TimSchonning/MINTS/README.md

<h1 align="center">Modular Integrated Network of Traffic Sensors (MINTS)</h1>

<!-- PROJECT SHIELDS -->
[][contributors-url]
[][forks-url]
[][stars-url]
[][issues-url]

<!-- ABOUT THE PROJECT -->
## About the Project
**NOTE:** *This project was a part of the authors' bachelor's thesis at Uppsala University.* <br>
[*Click here to access the thesis*][a]

[a]: https://www.diva-portal.org/smash/record.jsf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

MINTS is a star topology network of small, ground-level measurement stations equipped with sensors to monitor air quality and noise pollution in a dense, urban environment. The project aims to combat the flaws associated with traditional monitoring systems, which tend to be expensive, few in number, and often mounted on rooftops, farther from the directly affected areas on the ground.

The stations have been developed to allow for a plug-and-play system that can identify problematic ground-level areas at a greater scale. By continually monitoring affected areas more densely, it's possible to identify pollution patterns and to pinpoint local hotspots. The pollution data gathered by these stations can then be visualized in real-time on an interactive heatmap.

The primary beneficiaries of this project are the municipalities and the people who are troubled by pollution and traffic-related disturbances. Further, it provides the tools for responsive urbanism, making the day-to-day lives of citizens easier.

### Key Features
* **Ground-level Measurements:**    measures ground-level PM and noise pollution.
* **Real-Time Heatmap Generation:** Real-time visualisations of pollution data.
* **Low-Cost System:**              ~100 USD per node.
* **Scalability:**                  Support for upp to hundreds of nodes per gateway.
* **Low-Power LoRa Communication:** Optimised for long-range, battery-efficient data transmissions within an urban, ground-level environment.

<!-- [![Product Name Screen Shot][product-screenshot]](https://example.com) -->
### System Architecture

*For further details, please see chapters 3.3 and 3.4 in the thesis.*

#### Hardware Architecture

The measuring station is designed to be compact, energy-efficient, and easily expandable. It is powered by a 9V supply, providing a 4V overhead to handle battery degradation and protect voltage-sensitive components.

node_circuit

#### Software Architecture
The software architecture consists of four parts working together: frontend,
database, gateway, and node. The goal is to collect data from
the connected sensors, transmit it to the gateway, which uploads it to the
database, which can be read from the frontend to update the heatmap.

sysarc

### Tech Stack and Hardware Components

*For further details, please see chapter 3.2 in the thesis.*

#### Hardware
| Component | Model / Details | Purpose & Key Specifications |
| :--- | :--- | :--- |
| **Particle Sensor** | SEN-HM3301 | Monitors airborne fine particle concentrations ($PM_{1}$ and $PM_{2.5}$). |
| **Sound Sensor** | Waveshare (LM386 Amp) | Captures acoustic data (50–20,000 Hz range, 52 dB sensitivity). |
| **LoRa Module** | Core1262-HF (TCXO) | Handles wireless communication between nodes and the gateway. |
| **Microcontroller** | Arduino Nano (ESP32-S3 SoC) | Serves as the main processing board for each individual node. |
| **Gateway** | Raspberry Pi 3 Model B (1GB) | Bridges communication between the node network and the server. |
| **LoRa HAT** | Waveshare LoRa & GNSS | Gateway add-on board based on the SX1262 radio chip. |
| **Antennas** | 2J0C15-868-C885G & Bundled HAT Antenna | **Nodes:** 868MHz antenna via SMA to U.FL adapters.<br>**Gateway:** High-gain antenna bundled with the HAT. |
| **Misc. Electronics** | Capacitors, Resistors, Regulators | • 2x Electrolytic capacitors (10uF, 16V/50V)<br>• Resistors: 200Ω, 140Ω, 20Ω<br>• LD1117V33 voltage regulator (steps down to 3.3V, up to 0.95A). |
| **Power Supply** | 6x AA Batteries per node | Dual AA battery holder configuration per measurement station. |
| **Enclosure** | Custom 3D Printed Case | Custom PLA plastic chassis featuring an integrated PM10 insect/debris filter. |

#### Software & Libraries
| Tool / Library | Type | Function |
| :--- | :--- | :--- |
| **RadioLib** | Open-source Library | Provides low-level control and configuration for the SX1262 LoRa module. |
| **MapBox API** | Mapping Platform | Powering the interactive, customizable heatmap and layer handling. |
| **Firestore** | Database | Cloud-hosted NoSQL database used for storing and syncing station data. |

<!-- GETTING STARTED -->
## Getting Started
To get a local copy up and running, follow these steps.

### Prerequisites

Before running the backend or frontend web application, ensure you have the following installed:
* **Node.js** (LTS version `v24.x` or higher recommended)
* **npm** (v11.x or higher)
* **TypeScript**
* **C++**

### Installation

Navigate to the part of the project you want to run and follow the specific instructions in the respective READMEs.

### Repository Structure

```text
├── database/          # Firestore security rules and configurations
├── frontend/          # Web application source code and components (built with Svelte)
├── gateway/           # Packet forwarder configurations and gateway management scripts
├── node/              # Arduino/C++ firmware and PIN layouts for the LoRa sensor nodes
└── README.md          # Main project documentation and overview
```

<!-- ROADMAP -->
## Roadmap

See the [Gantt chart/roadmap](https://github.com/users/TimSchonning/projects/2) for a full view of the project development.

See also the [open issues](https://github.com/TimSchonning/MINTS/issues) for a full list of proposed features (and known issues).

<p align="right">(<a href="#readme-top">back to top</a>)</p>

<!-- LICENSE -->
## License

Distributed under the project_license. See `LICENSE.txt` for more information.

<!-- CONTACT -->
## Authors and Contact Information

For questions, support, or collaboration, reach out to the team:

**Filip Hellgren** <br />
*Frontend and database developer* <br />
Email:    filip.hellgren04@gmail.com <br />
Github:   www.github.com/Filip-Shellbranch <br />
LinkedIn: www.linkedin.com/in/filip-hellgren <br />

**Jenny Nilsson** <br />
*Frontend and database developer* <br />
Email:   nilssonjennylinnea@gmail.com <br />
Github:  www.github.com/jeni1263 <br />
LinkedIn: www.linkedin.com/in/jenny-nilsson-a7ab6a411<br />

**David Olmedo** <br />
*Node and gateway developer* <br />
Email:    david@olmedo.se <br />
Github:   www.github.com/DaOl6717 <br />
LinkedIn: www.linkedin.com/in/davolm/ <br />

**Tim Schönning** <br />
*Node and gateway developer* <br />
Email:    timschonning@gmail.com <br />
Github:   www.github.com/TimSchonning <br />
LinkedIn: www.linkedin.com/in/tim-sch%C3%B6nning-29a621226/ <br />

<p align="right">(<a href="#readme-top">back to top</a>)</p>

<!-- ACKNOWLEDGMENTS -->
## Acknowledgments

* We extend our sincere gratitude to the Sustainability InnoCenter for the generous funding and resources that made this project possible.

* Special thanks to Stamatopoulos at Sustainability InnoCenter for his openness to our ideas, encouragement, and role in bringing this project to reality.
  
* We are equally grateful to Svante Hagström at Sustainability InnoCenter for his support in managing external connections and facilitating collaboration throughout the process.

* We would also like to express our appreciation to our examiner, Calkin Suero Montero, for her feedback and guidance through multiple revisions, all of which significantly improved the quality of this work.

* Finally, we want to thank our Teaching Assistant, Kahlifa Fumo, for his guidance, technical insight, encouragement, and support throughout this project.

<p align="right">(<a href="#readme-top">back to top</a>)</p>

<!-- MARKDOWN LINKS & IMAGES -->
<!-- https://www.markdownguide.org/basic-syntax/#reference-style-links -->
[contributors-shield]: https://img.shields.io/github/contributors/TimSchonning/MINTS.svg?style=for-the-badge
[contributors-url]: https://github.com/TimSchonning/MINTS/graphs/contributors
[forks-shield]: https://img.shields.io/github/forks/TimSchonning/MINTS.svg?style=for-the-badge
[forks-url]: https://github.com/TimSchonning/MINTS/network/members
[stars-shield]: https://img.shields.io/github/stars/TimSchonning/MINTS.svg?style=for-the-badge
[stars-url]: https://github.com/TimSchonning/MINTS/stargazers
[issues-shield]: https://img.shields.io/github/issues/TimSchonning/MINTS.svg?style=for-the-badge
[issues-url]: https://github.com/TimSchonning/MINTS/issues
[license-shield]: https://img.shields.io/github/license/TimSchonning/MINTS.svg?style=for-the-badge
[license-url]: https://github.com/TimSchonning/MINTS/blob/main/LICENSE.txt
[linkedin-shield]: https://img.shields.io/badge/-LinkedIn-black.svg?style=for-the-badge&logo=linkedin&colorB=555
[linkedin-url]: https://linkedin.com/in/linkedin_username
[product-screenshot]: images/screenshot.png
<!-- Shields.io badges. You can a comprehensive list with many more badges at: https://github.com/inttter/md-badges -->
[Next.js]: https://img.shields.io/badge/next.js-000000?style=for-the-badge&logo=nextdotjs&logoColor=white
[Next-url]: https://nextjs.org/
[React.js]: https://img.shields.io/badge/React-20232A?style=for-the-badge&logo=react&logoColor=61DAFB
[React-url]: https://reactjs.org/
[Vue.js]: https://img.shields.io/badge/Vue.js-35495E?style=for-the-badge&logo=vuedotjs&logoColor=4FC08D
[Vue-url]: https://vuejs.org/
[Angular.io]: https://img.shields.io/badge/Angular-DD0031?style=for-the-badge&logo=angular&logoColor=white
[Angular-url]: https://angular.io/
[Svelte.dev]: https://img.shields.io/badge/Svelte-4A4A55?style=for-the-badge&logo=svelte&logoColor=FF3E00
[Svelte-url]: https://svelte.dev/
[Laravel.com]: https://img.shields.io/badge/Laravel-FF2D20?style=for-the-badge&logo=laravel&logoColor=white
[Laravel-url]: https://laravel.com
[Bootstrap.com]: https://img.shields.io/badge/Bootstrap-563D7C?style=for-the-badge&logo=bootstrap&logoColor=white
[Bootstrap-url]: https://getbootstrap.com
[JQuery.com]: https://img.shields.io/badge/jQuery-0769AD?style=for-the-badge&logo=jquery&logoColor=white
[JQuery-url]: https://jquery.com
