TimSchonning/MINTS/(list of files, cad)

Other CAD files:
gateway/src/main.obj
gateway/src/gatewayLogic.obj
