TimSchonning/MINTS/experiments/results/LoRa_propogation/raw/Experiment 1 - Low range dense city centre.md

 Address: Bäverns gränd 5
 T1: 82 m (fri sikt) 
 T2: 86 m 
 T3: 100 m 
 T4: 135 m

![[Pasted image 20260428101043.png]]
 ![[Pasted image 20260428095902.png|693]]

# DATA #

###  T1 ###

Button pressed! Continuing program...
Beginning to listen 3 seconds for config 1
Initialising LoRa with parameters:
Frequency: 868.10 | Bandwidth: 125.00 | Spreading Factor: 8
LoRa ready.
1Packet Received! RSSI: -83.00 dBm, SNR: 14.00
2Packet Received! RSSI: -82.00 dBm, SNR: 14.75
3Packet Received! RSSI: -82.00 dBm, SNR: 15.00
4Packet Received! RSSI: -81.00 dBm, SNR: 13.00
5Packet Received! RSSI: -81.00 dBm, SNR: 13.25
6Packet Received! RSSI: -82.00 dBm, SNR: 13.75
7Packet Received! RSSI: -82.00 dBm, SNR: 14.75
8Packet Received! RSSI: -81.00 dBm, SNR: 13.00
9Packet Received! RSSI: -82.00 dBm, SNR: 13.75
10Packet Received! RSSI: -81.00 dBm, SNR: 13.00
11Packet Received! RSSI: -81.00 dBm, SNR: 13.25
12Packet Received! RSSI: -82.00 dBm, SNR: 13.75
13Packet Received! RSSI: -82.00 dBm, SNR: 14.25
14Packet Received! RSSI: -81.00 dBm, SNR: 13.50
15Packet Received! RSSI: -82.00 dBm, SNR: 14.75
16Packet Received! RSSI: -83.00 dBm, SNR: 14.50
17Packet Received! RSSI: -82.00 dBm, SNR: 14.00
18Packet Received! RSSI: -84.00 dBm, SNR: 13.25
19Packet Received! RSSI: -82.00 dBm, SNR: 14.25
20Packet Received! RSSI: -82.00 dBm, SNR: 14.00
21Packet Received! RSSI: -81.00 dBm, SNR: 13.25
22Packet Received! RSSI: -82.00 dBm, SNR: 14.75
23Packet Received! RSSI: -82.00 dBm, SNR: 13.50
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
Frequency: 868.10 | Bandwidth: 250.00 | Spreading Factor: 10

Average RSSI: -111.88 dBm
Average SNR:  -10.34 dB
Packet loss:  0.00 %

--- Results for config 6 ---
Frequency: 868.10 | Bandwidth: 250.00 | Spreading Factor: 12

Average RSSI: -113.26 dBm
Average SNR:  -12.49 dB
Packet loss:  0.00 %
