TimSchonning/MINTS/experiments/results/LoRa_propogation/raw/Experiment 2 - Medium range dense city centre.md

Address: Bäverns gränd 5
T1: 183 m (fri sikt) 
T2: 184 m 
T3: 189 m 
T4: 207 m

![[Pasted image 20260428101058.png]]
 
![[Pasted image 20260428100431.png]]

# DATA #

###  T1 ###

Button pressed! Continuing program...
Beginning to listen 3 seconds for config 1
Initialising LoRa with parameters:
Frequency: 868.10 | Bandwidth: 125.00 | Spreading Factor: 8
LoRa ready.
1Packet Received! RSSI: -85.00 dBm, SNR: 14.00
2Packet Received! RSSI: -85.00 dBm, SNR: 13.75
3Packet Received! RSSI: -84.00 dBm, SNR: 13.00
4Packet Received! RSSI: -85.00 dBm, SNR: 13.25
5Packet Received! RSSI: -85.00 dBm, SNR: 13.75
6Packet Received! RSSI: -85.00 dBm, SNR: 13.25
7Packet Received! RSSI: -85.00 dBm, SNR: 14.00
8Packet Received! RSSI: -85.00 dBm, SNR: 13.00
9Packet Received! RSSI: -85.00 dBm, SNR: 13.75
10Packet Received! RSSI: -85.00 dBm, SNR: 13.50
11Packet Received! RSSI: -86.00 dBm, SNR: 13.25
12Packet Received! RSSI: -85.00 dBm, SNR: 14.00
13Packet Received! RSSI: -85.00 dBm, SNR: 14.00
14Packet Received! RSSI: -87.00 dBm, SNR: 12.75
15Packet Received! RSSI: -87.00 dBm, SNR: 12.25
16Packet Received! RSSI: -87.00 dBm, SNR: 12.50
17Packet Received! RSSI: -86.00 dBm, SNR: 12.50
18Packet Received! RSSI: -87.00 dBm, SNR: 12.50
19Packet Received! RSSI: -86.00 dBm, SNR: 12.75
20Packet Received! RSSI: -86.00 dBm, SNR: 12.75
21Packet Received! RSSI: -87.00 dBm, SNR: 12.50
22Packet Received! RSSI: -87.00 dBm, SNR: 12.75
23Packet Received! RSSI: -87.00 dBm, SNR: 12.50
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
Frequency: 868.10 | Bandwidth: 250.00 | Spreading Factor: 10

Average RSSI: -119.87 dBm
Average SNR:  -15.92 dB
Packet loss:  52.00 %

--- Results for config 6 ---
Frequency: 868.10 | Bandwidth: 250.00 | Spreading Factor: 12

Average RSSI: -120.02 dBm
Average SNR:  -16.35 dB
Packet loss:  8.00 %
