TimSchonning/MINTS/experiments/results/LoRa_propogation/raw/Experiment 3 - Long range dense city centre.md

Address: Bäverns gränd 5
T1: 338 m (fri sikt) 
T2: 339 m 
T3: 344 m 
T4: 351 m

![[Pasted image 20260428101110.png]]
 
![[Pasted image 20260428100459.png]]

# DATA #

###  T1 ###

Button pressed! Continuing program...
Beginning to listen 3 seconds for config 1
Initialising LoRa with parameters:
Frequency: 868.10 | Bandwidth: 125.00 | Spreading Factor: 8
LoRa ready.
1Packet Received! RSSI: -107.00 dBm, SNR: 0.00
2Packet Received! RSSI: -106.00 dBm, SNR: -0.25
3Packet Received! RSSI: -107.00 dBm, SNR: -0.50
4Packet Received! RSSI: -107.00 dBm, SNR: 0.25
5Packet Received! RSSI: -107.00 dBm, SNR: -2.00
6Packet Received! RSSI: -108.00 dBm, SNR: -3.50
7Packet Received! RSSI: -109.00 dBm, SNR: -5.00
8Packet Received! RSSI: -108.00 dBm, SNR: -3.75
9Packet Received! RSSI: -107.00 dBm, SNR: -2.00
10Packet Received! RSSI: -108.00 dBm, SNR: -3.50
11Packet Received! RSSI: -107.00 dBm, SNR: -2.75
12Packet Received! RSSI: -107.00 dBm, SNR: -2.25
13Packet Received! RSSI: -107.00 dBm, SNR: -3.25
14Packet Received! RSSI: -107.00 dBm, SNR: -2.25
15Packet Received! RSSI: -108.00 dBm, SNR: -4.25
16Packet Received! RSSI: -109.00 dBm, SNR: -4.25
17Packet Received! RSSI: -107.00 dBm, SNR: -2.75
18Packet Received! RSSI: -107.00 dBm, SNR: -2.75
19Packet Received! RSSI: -106.00 dBm, SNR: -1.50
20Packet Received! RSSI: -107.00 dBm, SNR: -0.75
21Packet Received! RSSI: -107.00 dBm, SNR: 0.25
22Packet Received! RSSI: -107.00 dBm, SNR: 2.00
23Packet Received! RSSI: -106.00 dBm, SNR: 2.25
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
Frequency: 868.10 | Bandwidth: 250.00 | Spreading Factor: 8

Average RSSI: nan dBm
Average SNR:  nan dB
Packet loss:  100.00 %

--- Results for config 5 ---
Frequency: 868.10 | Bandwidth: 250.00 | Spreading Factor: 10

Average RSSI: nan dBm
Average SNR:  nan dB
Packet loss:  100.00 %

--- Results for config 6 ---
Frequency: 868.10 | Bandwidth: 250.00 | Spreading Factor: 12

Average RSSI: -125.03 dBm
Average SNR:  -19.29 dB
Packet loss:  64.00 %
