TimSchonning/MINTS/experiments/results/LoRa_propogation/raw/Experiment 4 - Urban park with trees.md

Address: Stadsträdgården 
T1: 247 m 
T2: 405 m
T3: 407 m
T4: 427 m
 
![[Pasted image 20260428101121.png]]

# DATA #

###  T1 ###

Button pressed! Continuing program...
Beginning to listen 3 seconds for config 1
Initialising LoRa with parameters:
Frequency: 868.10 | Bandwidth: 125.00 | Spreading Factor: 8
LoRa ready.
1Packet Received! RSSI: -111.00 dBm, SNR: -2.75
2Packet Received! RSSI: -111.00 dBm, SNR: -2.25
3Packet Received! RSSI: -110.00 dBm, SNR: -1.75
4Packet Received! RSSI: -112.00 dBm, SNR: -3.00
5Packet Received! RSSI: -111.00 dBm, SNR: -2.25
6Packet Received! RSSI: -109.00 dBm, SNR: -0.75
7Packet Received! RSSI: -110.00 dBm, SNR: -1.50
8Packet Received! RSSI: -111.00 dBm, SNR: -2.25
9Packet Received! RSSI: -110.00 dBm, SNR: -1.25
10Packet Received! RSSI: -111.00 dBm, SNR: -2.50
11Packet Received! RSSI: -111.00 dBm, SNR: -2.00
12Packet Received! RSSI: -109.00 dBm, SNR: -0.50
13Packet Received! RSSI: -109.00 dBm, SNR: -0.50
14Packet Received! RSSI: -110.00 dBm, SNR: -1.00
15Packet Received! RSSI: -109.00 dBm, SNR: 0.25
16Packet Received! RSSI: -108.00 dBm, SNR: 0.50
17Packet Received! RSSI: -107.00 dBm, SNR: 2.00
18Packet Received! RSSI: -107.00 dBm, SNR: 1.75
19Packet Received! RSSI: -107.00 dBm, SNR: 1.25
20Packet Received! RSSI: -107.00 dBm, SNR: 2.00
21Packet Received! RSSI: -107.00 dBm, SNR: 2.00
22Packet Received! RSSI: -106.00 dBm, SNR: 2.50
23Packet Received! RSSI: -106.00 dBm, SNR: 2.25
24Packet Received! RSSI: -106.00 dBm, SNR: 2.25
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
Frequency: 868.10 | Bandwidth: 250.00 | Spreading Factor: 10

Average RSSI: -120.87 dBm
Average SNR:  -16.30 dB
Packet loss:  68.00 %

--- Results for config 6 ---
Frequency: 868.10 | Bandwidth: 250.00 | Spreading Factor: 12

Average RSSI: -124.22 dBm
Average SNR:  -18.86 dB
Packet loss:  46.00 %
