TimSchonning/MINTS/experiments/results/LoRa_propogation/raw/Experiment 5 - Long distance mixed park and residential housing.md

Address: Botaniska trädgården
T1: 456 m 
T2: 764 m 
T3: 780 m 
T4: 800 m

![[Pasted image 20260428101138.png]]
 
![[Pasted image 20260428100744.png]]

# DATA #

###  T1 ###

Node set as RECEIVER.
Waiting for button press...
Button pressed! Continuing program...
Beginning to listen 3 seconds for config 1
Initialising LoRa with parameters:
Frequency: 868.10 | Bandwidth: 125.00 | Spreading Factor: 8
LoRa ready.
1Packet Received! RSSI: -114.00 dBm, SNR: -6.75
2Packet Received! RSSI: -114.00 dBm, SNR: -7.00
3Packet Received! RSSI: -114.00 dBm, SNR: -6.50
4Packet Received! RSSI: -114.00 dBm, SNR: -6.75
5Packet Received! RSSI: -113.00 dBm, SNR: -6.25
6Packet Received! RSSI: -115.00 dBm, SNR: -7.50
7Packet Received! RSSI: -114.00 dBm, SNR: -6.50
8Packet Received! RSSI: -113.00 dBm, SNR: -6.25
9Packet Received! RSSI: -114.00 dBm, SNR: -6.25
10Packet Received! RSSI: -114.00 dBm, SNR: -7.00
11Packet Received! RSSI: -114.00 dBm, SNR: -6.75
12Packet Received! RSSI: -114.00 dBm, SNR: -6.25
13Packet Received! RSSI: -114.00 dBm, SNR: -6.00
14Packet Received! RSSI: -115.00 dBm, SNR: -7.25
15Packet Received! RSSI: -114.00 dBm, SNR: -6.25
16Packet Received! RSSI: -113.00 dBm, SNR: -6.00
17Packet Received! RSSI: -113.00 dBm, SNR: -6.00
18Packet Received! RSSI: -113.00 dBm, SNR: -6.00
19Packet Received! RSSI: -114.00 dBm, SNR: -6.25
20Packet Received! RSSI: -113.00 dBm, SNR: -5.50
21Packet Received! RSSI: -113.00 dBm, SNR: -5.75
22Packet Received! RSSI: -113.00 dBm, SNR: -5.50
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
Frequency: 868.10 | Bandwidth: 250.00 | Spreading Factor: 10

Average RSSI: -112.84 dBm
Average SNR:  -5.74 dB
Packet loss:  0.00 %

--- Results for config 6 ---
Frequency: 868.10 | Bandwidth: 250.00 | Spreading Factor: 12

Average RSSI: -111.22 dBm
Average SNR:  -4.09 dB
Packet loss:  0.00 %
