TimSchonning/MINTS/experiments/results/LoRa_propogation/raw/Experiment 6 - Long distance open space reference.md

Address: Långt bort som fan 
T1: 250 m 
T2: 500 m 
T3: 750 m 
T4: 1000 m 
T5: 1250 m
 
![[Pasted image 20260428100842.png]]

# DATA #

###  T1 ###

Button pressed! Continuing program...
Beginning to listen 3 seconds for config 1
Initialising LoRa with parameters:
Frequency: 868.10 | Bandwidth: 125.00 | Spreading Factor: 8
LoRa ready.
1Packet Received! RSSI: -118.00 dBm, SNR: -7.50
2Packet Received! RSSI: -118.00 dBm, SNR: -8.00
3Packet Received! RSSI: -118.00 dBm, SNR: -8.75
4Packet Received! RSSI: -117.00 dBm, SNR: -7.75
5Packet Received! RSSI: -117.00 dBm, SNR: -8.25
6Packet Received! RSSI: -116.00 dBm, SNR: -6.50
7Packet Received! RSSI: -116.00 dBm, SNR: -6.75
8Packet Received! RSSI: -117.00 dBm, SNR: -7.75
9Packet Received! RSSI: -116.00 dBm, SNR: -6.50
10Packet Received! RSSI: -116.00 dBm, SNR: -7.00
11Packet Received! RSSI: -117.00 dBm, SNR: -7.50
12Packet Received! RSSI: -117.00 dBm, SNR: -7.00
13Packet Received! RSSI: -117.00 dBm, SNR: -7.25
14Packet Received! RSSI: -117.00 dBm, SNR: -7.25
15Packet Received! RSSI: -117.00 dBm, SNR: -7.75
16Packet Received! RSSI: -118.00 dBm, SNR: -8.00
17Packet Received! RSSI: -117.00 dBm, SNR: -7.00
18Packet Received! RSSI: -117.00 dBm, SNR: -8.00
19Packet Received! RSSI: -117.00 dBm, SNR: -7.75
20Packet Received! RSSI: -117.00 dBm, SNR: -8.00
21Packet Received! RSSI: -117.00 dBm, SNR: -7.75
22Packet Received! RSSI: -119.00 dBm, SNR: -8.75
23Packet Received! RSSI: -118.00 dBm, SNR: -8.25
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

Average RSSI: -121.37 dBm
Average SNR:  -17.34 dB
Packet loss:  100.00 %

--- Results for config 6 ---
Frequency: 868.10 | Bandwidth: 250.00 | Spreading Factor: 12

Average RSSI: -121.13 dBm
Average SNR:  -15.32 dB
Packet loss:  100.00 %
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
