TimSchonning/MINTS/experiments/results/LoRa_propogation/raw/Experiment 7.md

T1

Button pressed! Continuing program...
Beginning to listen 3 seconds for config 1
Initialising LoRa with parameters:
Frequency: 868.10 | Bandwidth: 125.00 | Spreading Factor: 8
LoRa ready.
1Packet Received! RSSI: -110.00 dBm, SNR: -2.75
2Packet Received! RSSI: -111.00 dBm, SNR: -3.25
3Packet Received! RSSI: -110.00 dBm, SNR: -2.50
4Packet Received! RSSI: -111.00 dBm, SNR: -3.50
5Packet Received! RSSI: -109.00 dBm, SNR: -1.25
6Packet Received! RSSI: -108.00 dBm, SNR: -0.25
7Packet Received! RSSI: -108.00 dBm, SNR: 0.00
8Packet Received! RSSI: -108.00 dBm, SNR: -0.25
9Packet Received! RSSI: -108.00 dBm, SNR: 0.00
10Packet Received! RSSI: -108.00 dBm, SNR: 0.00
11Packet Received! RSSI: -108.00 dBm, SNR: 0.00
12Packet Received! RSSI: -108.00 dBm, SNR: 0.25
13Packet Received! RSSI: -108.00 dBm, SNR: -0.50
14Packet Received! RSSI: -107.00 dBm, SNR: 0.50
15Packet Received! RSSI: -106.00 dBm, SNR: 0.75
16Packet Received! RSSI: -107.00 dBm, SNR: 1.00
17Packet Received! RSSI: -107.00 dBm, SNR: 1.00
18Packet Received! RSSI: -108.00 dBm, SNR: 0.50
19Packet Received! RSSI: -106.00 dBm, SNR: 1.25
20Packet Received! RSSI: -107.00 dBm, SNR: 0.50
21Packet Received! RSSI: -107.00 dBm, SNR: 1.25
22Packet Received! RSSI: -106.00 dBm, SNR: 1.75
23Packet Received! RSSI: -107.00 dBm, SNR: 1.00
24Packet Received! RSSI: -106.00 dBm, SNR: 0.75
25Packet Received! RSSI: -106.00 dBm, SNR: 1.25
26Packet Received! RSSI: -107.00 dBm, SNR: 0.75
27Packet Received! RSSI: -107.00 dBm, SNR: 1.00
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
2Packet Received! RSSI: -113.00 dBm, SNR: -7.75
3Packet Received! RSSI: -116.00 dBm, SNR: -10.75
4Packet Received! RSSI: -113.00 dBm, SNR: -8.75
5Packet Received! RSSI: -108.00 dBm, SNR: -4.25
6Packet Received! RSSI: -109.00 dBm, SNR: -4.25
7Packet Received! RSSI: -109.00 dBm, SNR: -4.75
8Packet Received! RSSI: -109.00 dBm, SNR: -4.50
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
