TimSchonning/MINTS/experiments/results/LoRa_propogation/plots/Experiment 1 - Bandwidth 125 kHz.png

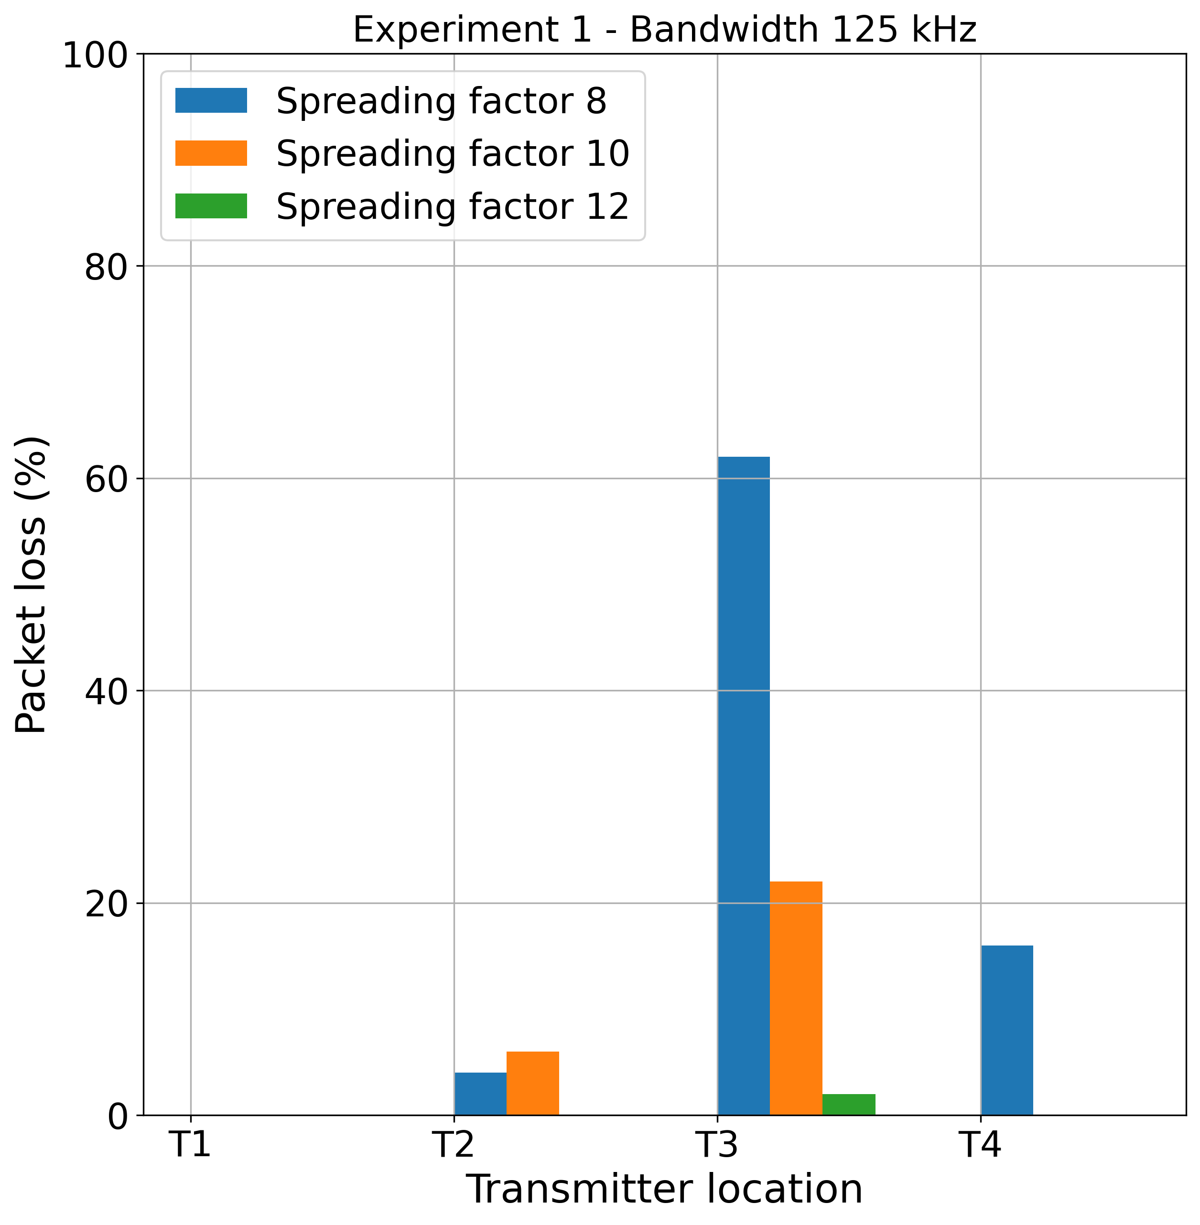
experiments/results/LoRa_propogation/plots/Experiment 1 - Bandwidth 125 kHz.png
