TimSchonning/MINTS/experiments/results/LoRa_propogation/plots/Experiment 2 - Bandwidth 125 kHz.png

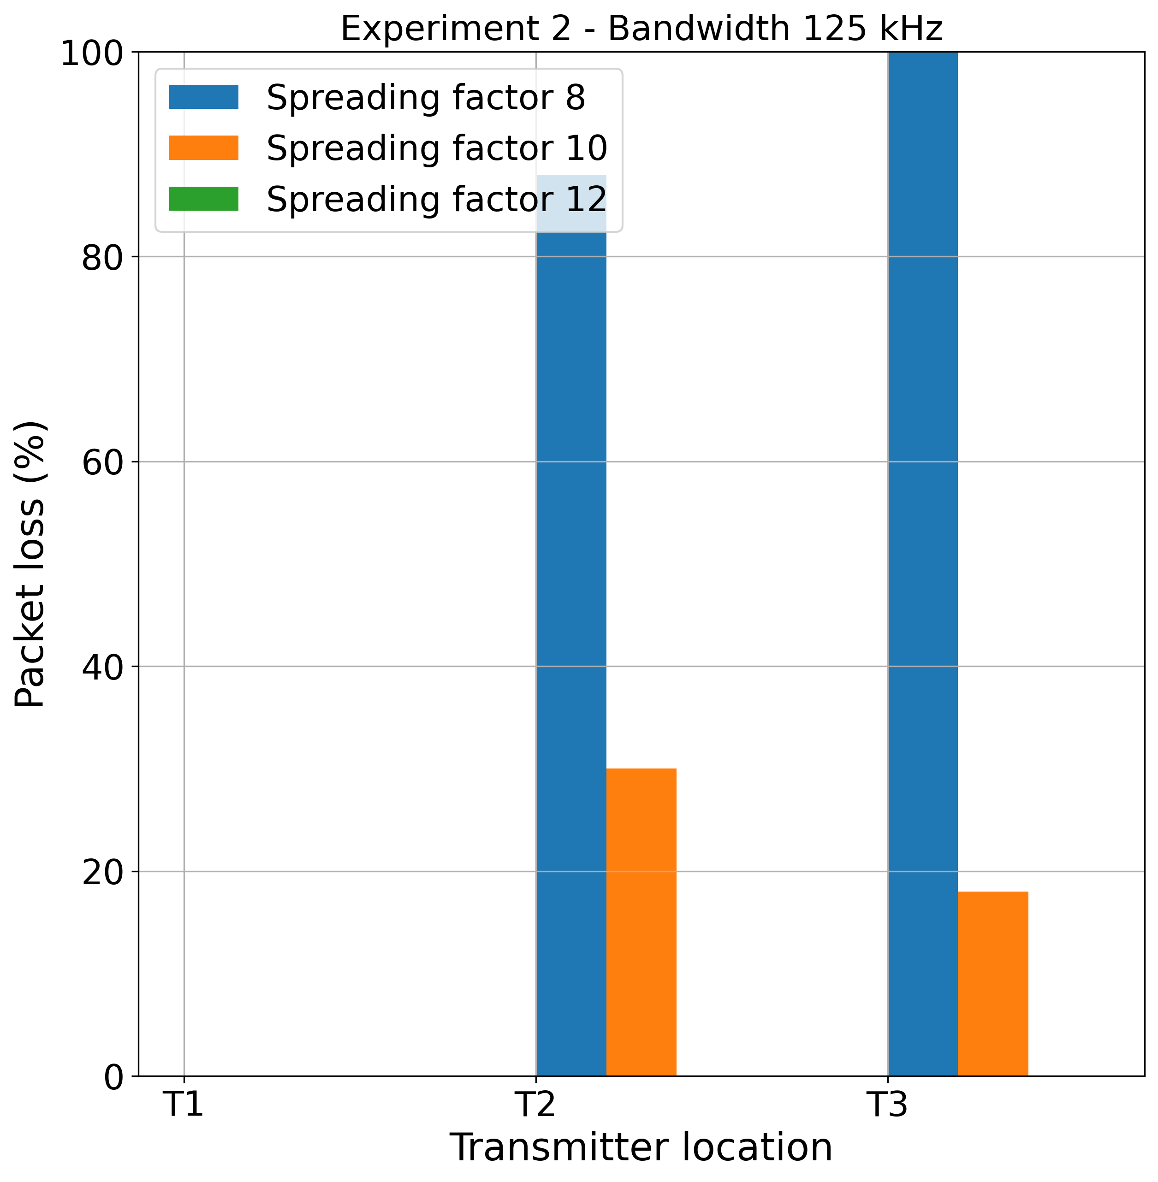
experiments/results/LoRa_propogation/plots/Experiment 2 - Bandwidth 125 kHz.png
