TimSchonning/MINTS/experiments/results/LoRa_propogation/plots/Experiment 6 - Bandwidth 250 kHz.png

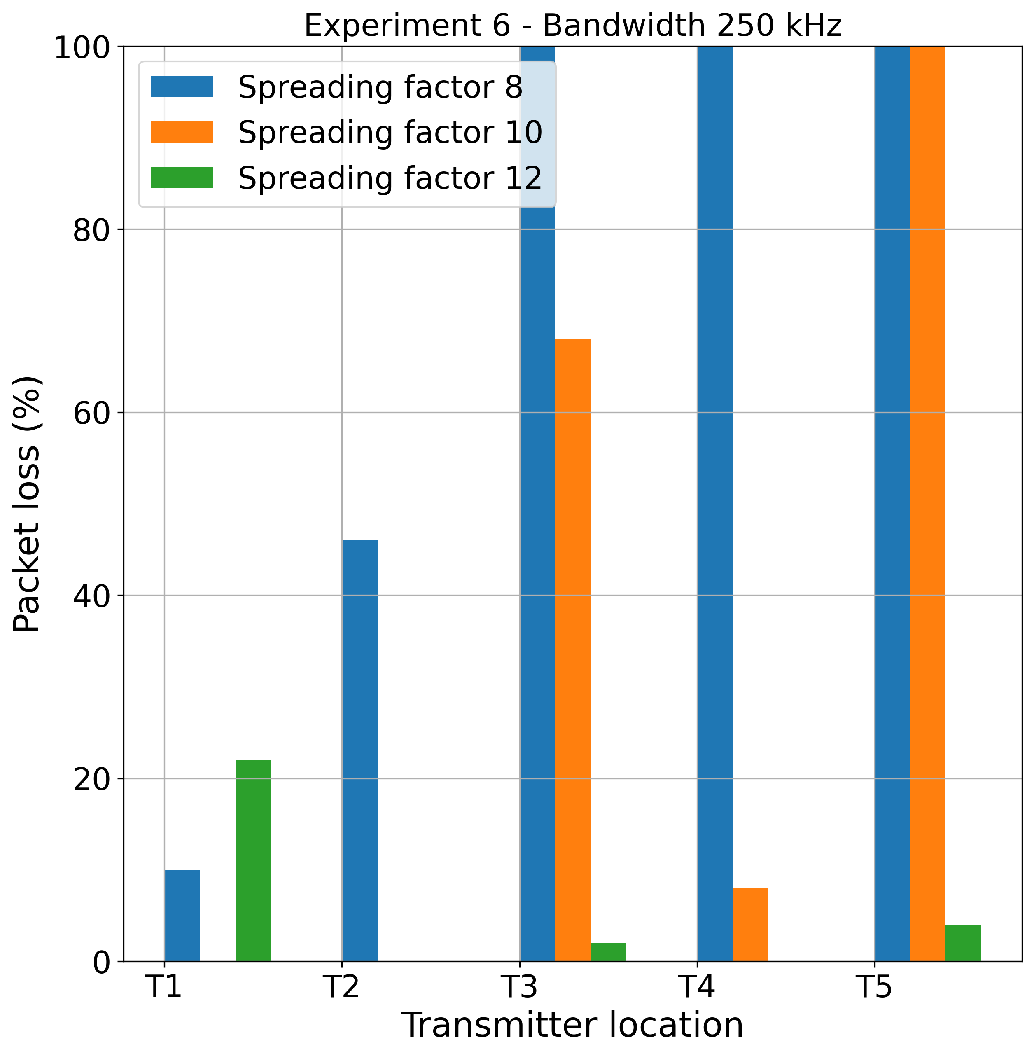
experiments/results/LoRa_propogation/plots/Experiment 6 - Bandwidth 250 kHz.png
