TimSchonning/MINTS/experiments/results/sound_sensor_calibration/CalibrationPlotAB.png

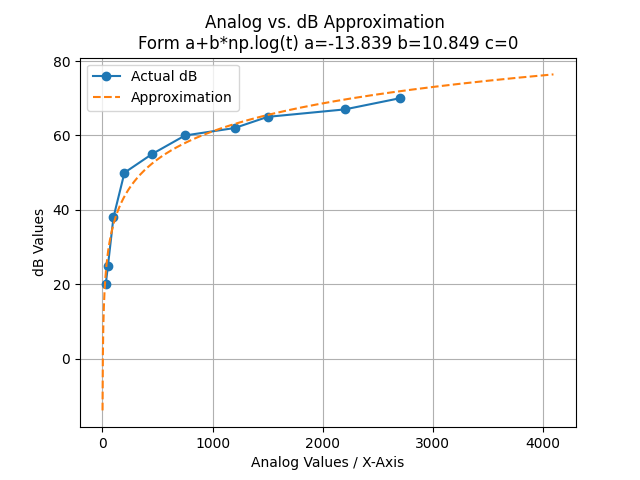
experiments/results/sound_sensor_calibration/CalibrationPlotAB.png
