TimSchonning/MINTS/experiments/results/sound_sensor_calibration/CalibrationPlotABC.png

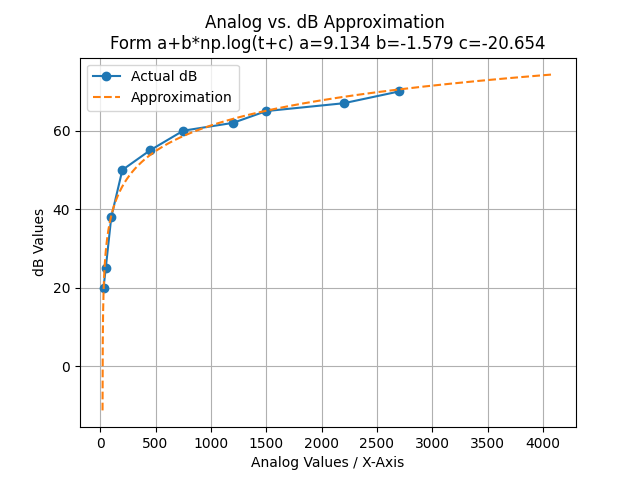
experiments/results/sound_sensor_calibration/CalibrationPlotABC.png
