TimSchonning/MINTS/test_runs/aug13-14/OfficialComparison.png

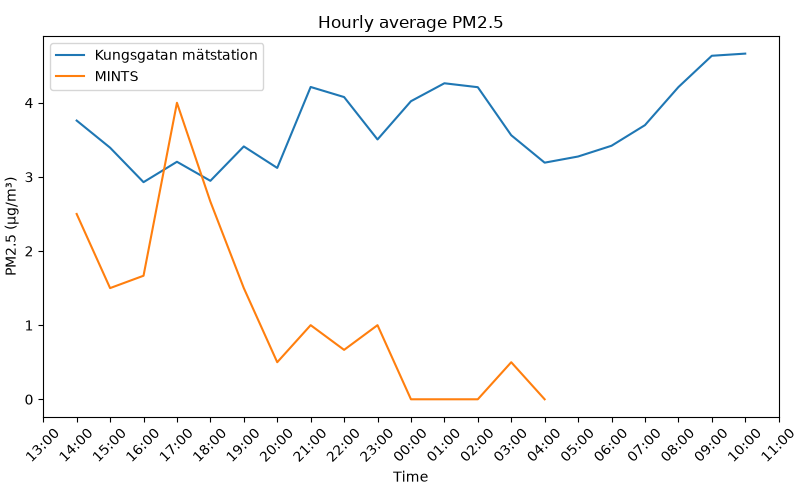
test_runs/aug13-14/OfficialComparison.png
