TimSchonning/MINTS/node/include/debug_macros.h

#ifndef DEBUG_MACROS_H
#define DEBUG_MACROS_H


#define DEBUG_MODE // Comment this to disable debug mode

#ifdef DEBUG_MODE
  #define DEBUG_PRINT(...)   Serial.print(__VA_ARGS__)
  #define DEBUG_PRINTLN(x) Serial.println(x)
  #define DEBUG_BEGIN(x) Serial.begin(x)
#else
  #define DEBUG_PRINT(x)
  #define DEBUG_PRINTLN(x)
  #define DEBUG_BEGIN(x)
#endif

#endif
