TimSchonning/MINTS/node/include/encode_payload.h

#ifndef ENCODE_PAYLOAD_H
#define ENCODE_PAYLOAD_H

#include <stdint.h>
#include "sensor_logic.h"
#include "protocol.h"

/**
 * @brief  Returns the encoded payload.
 * @param  payload: the payload.
 * @param  ps_result: PM results.
 * @param  ns_result: Sound sensor results.
 * @return Success indicator
 */
bool encode_payload(payload_t* payload, ps_result_t* ps_result, ns_result_t* ns_result);

/**
 * @brief High-level function.
 * Initializes radio and transmits via LoRa.
 * @return Success indicator
 */
bool transmit_payload(payload_t* payload);

#endif
