TimSchonning/MINTS/node/src/encode_payload.cpp

#include "config.h"
#include "debug_macros.h"
#include "encode_payload.h"
#include "sensor_logic.h"
#include "utils.h"

#include <stdint.h>
#include <RadioLib.h>

extern SX1262 radio;

bool encode_payload(payload_t* payload, ps_result_t* ps_result, ns_result_t* ns_result) {
    if (!payload || !ps_result || !ns_result) return false;
    
    payload->type       = MSG_TYPE_PAYLOAD_UPLINK;
    payload->node_id    = node_id;
    payload->reading_id = boot_count;
    
    uint16_t index = buffering_counter * 4;
    
    payload->readings[index]     = ps_result->pm1;
    payload->readings[index + 1] = ps_result->pm25;
    payload->readings[index + 2] = (uint8_t)((ns_result->noise_avg >> 8) & 0xFF); 
    payload->readings[index + 3] = (uint8_t)(ns_result->noise_avg & 0xFF);
    
    add_to_nvs(boot_count, ps_result->pm1, ps_result->pm25, ns_result->noise_avg);

    return true;
}

bool transmit_payload(payload_t* payload) {

    int16_t state = radio.begin(FREQUENCY, BANDWIDTH, SPREADING_FACTOR, CODING_RATE, SYNC_WORD, POWER, PREAMBLE_LEN);
    if (error_handler(state, false, UNDEFINED_ERROR, "LoRa initialisation")) return false;

    uint8_t counter = 0;
    while (counter < MAX_TX_RETRIES) {
        uint8_t payload_size = 3 + BUFFERING_THRESHOLD * 4;
        state = radio.transmit((uint8_t*)payload, payload_size);
        error_handler(state, false, UNDEFINED_ERROR, "LoRa payload transmission");
        
        DEBUG_PRINTLN("[SUCCESS] Payload sent, waiting for ACK");

        msg_ack_t payload_ack;
        state = radio.receive((uint8_t*)&payload_ack, sizeof(msg_ack_t));

        if (state == RADIOLIB_ERR_NONE) {
            if (payload_ack.type    == MSG_TYPE_ACK &&
                payload_ack.node_id == node_id &&
                payload_ack.ack_for == MSG_TYPE_PAYLOAD_UPLINK) {
                    return true;
            }
        }
        counter++;
    }
    return false;
}
