TimSchonning/MINTS/(commit log)

2026-03-25 HM330X logic added
    Added a "get all pm avg" function for the HM330X sensor
2026-03-25 Arduino setup() update
    Added necessary power optimizations
2026-03-28 Prototype v1 for webpage
2026-04-08 refactor: change measurement_type to sensor_type
2026-04-08 docs: added documentation and struct definitions for sensor reading
2026-04-08 fix: minor header fix
    [sensor_logic.h]
2026-04-08 heatmap med punkt
2026-04-09 fix: payload_t content update
    Added id (8 bits)
    Removed pm10
    Size change pm (16 to 8 bits)
    [encode_payload.cpp, encode_payload.h, sensor_logic.cpp, sensor_logic.h]
2026-04-09 feat: added the logic for the sound sensor
2026-04-09 docs: updated documentation and struct definitions for the sound sensor
2026-04-09 refactor: renamed peak to noise_peak in ss_res_t and elsewhere
    [encode_payload.cpp, sensor_logic.cpp, sensor_logic.h]
2026-04-10 docs: minor sensor_logic corrections
    [sensor_logic.cpp, sensor_logic.h]
2026-04-10 feat: added a temporary test button to add a station to firebase
2026-04-10 fix: minor encode_payload struct fix
    [encode_payload.h]
2026-04-10 feat: added log functions to the sensors
2026-04-10 refactor: major sensor_logic refactoring
2026-04-10 fix: minor sensor fixes
    [encode_payload.cpp, encode_payload.h]
2026-04-13 fix: fixed imports from heatmap after move
2026-04-13 feat: added function to load information about all sensor types when the program starts so they can be used later in the map
2026-04-13 feat: added function to qucikly get sensor type information using the id.
2026-04-14 feat(sensor_logic.cpp): added "debug modes" to ps_parse and ns_parse
    Added a "debug mode" to the sensor parsers, which will serial.print() their respective avg. results for debugging
2026-04-14 feat(main.cpp): added a deep-sleep timer
2026-04-14 refactor: moved error_handler() and power_down_radios() into utils
    [encode_payload.h, main.cpp, sensor_logic.h, utils.cpp, utils.h]
2026-04-15 feat: started integration with heatmap and slider
2026-04-15 Made main.cpp compile and run.
    [main.obj]
2026-04-15 docs: added documentation to utils.cpp
    Functions affected:
    error_handler
    power_down_radios
    initialise_node
    [utils.h]
2026-04-15 feat: made the heatmap display measurements
2026-04-16 docs(sensor_logic): update
2026-04-16 feat: changed radius and intensity of heatmap
2026-04-16 feat: added docs to standby_mode and made some fixes
    [utils.cpp, utils.h]
2026-04-16 LoRa gateway works. Can receive and get correct data to python (prepare for firebase)
    [main.obj]
2026-04-16 Updated LoRa Arduino code to work with gateway main file.
2026-04-16 Documentation and clean up
    [main.obj]
2026-04-16 Added compiled gatewayLogic file
    [gatewayLogic.obj]
2026-04-16 feat: fixed filters
2026-04-19 feat: removed hardcoded list of sensor types
2026-04-20 fix: removed the nodes need to ack the gateway upon received ID
    [utils.cpp]
2026-04-20 feat: stubbed the sleep functions of the sensors
2026-04-20 fix: updated some error messages
    [utils.cpp]
2026-04-20 fix: minor bug fixes
    [utils.cpp]
2026-04-20 fix: update to error messages
    [main.cpp, utils.cpp]
2026-04-20 feat: begun the development of batching the sensor readings
2026-04-22 fix: minor protocol bug fix
    [protocol.h]
2026-04-22 feat: added tlv encoders - move to gateway when applicable
2026-04-23 fix: added nvs logic to backlog
    [utils.cpp]
2026-05-04 Changes to get gatewayLogic to run on raspberry pi
2026-05-04 Added some files to gitignore
    [gatewayLogic.obj]
2026-05-04 feat(encode_payload): node now also writes readings to flash
    Uses boot_count as ID for the reading.
    pm1 => i_%u_p1
    pm2,5 => i_%u_p2
    noise => i_%u_n
    [encode_payload.cpp, main.cpp, utils.cpp, utils.h]
2026-05-04 Added test print
2026-05-05 fix(macros): macros adapted towards cpp
    [debug_macros.h]
2026-05-05 fix: minor macro bug fix
    [debug_macros.h]
2026-05-05 feat(utils): error handler added
    [utils.cpp, utils.h]
2026-05-05 fix: batched bug fixes
    [config.h, debug_macros.h, encode_payload.cpp, encode_payload.h, main.cpp, protocol.h, sensor_logic.cpp, sensor_logic.h]
2026-05-06 Updated pin configuration.
2026-05-06 Bug fix: removed print causing value error bug.
2026-05-11 feat: added a message struct for error messages
    [protocol.h, utils.cpp]
2026-05-11 feat: updated error_handler (utils) to now transmit error messages to the gateway
    [protocol.h, utils.cpp]
2026-05-11 feat: updated all error_handler to reflect the latest changes
    [encode_payload.cpp, protocol.h, utils.cpp]
2026-05-11 feat: added a struct for error handling
    Will be used to read error messages from the nodes.
    [protocol.h]
2026-05-11 fix: update to protocol.h
    Added node error message struct.
    Previous commit added it to the wrong protocol.h - no damage done though.
    [protocol.h]
2026-05-11 fix: noise sensor now reads a 12-bit value
    10-bit ADC -> 12-bit ADC
    [sensor_logic.cpp]
2026-05-11 docs: noise sensor cocumentation update
    [sensor_logic.h]
2026-05-11 fix: dynamic calculation of the number of batched sensor readings
2026-05-11 fix: changed pm10 to pm1 where applicable
    [encode_payload.cpp, heltec_LoRa_sniffer.ino, protocol.h, sensor_logic.cpp, sensor_logic.h]
2026-05-12 fix: potential noise_sensor bug fix
    Removed the 1 ms delay between each parse of the noise sensor due to concerns of it skewing the results.
    Has to be hardware tested! There's now a risk that the noise sensor draws too much power or that it'll have detrimental side effects
    [sensor_logic.cpp]
2026-05-12 feat: noise sensor now calculates peak averages instead of instances
    [config.h, sensor_logic.cpp, sensor_logic.h]
2026-05-13 misc: minor print for debugging added
2026-05-13 misc: minor prints for debugging
2026-05-13 fix: update to payload_t
    [protocol.h]
2026-05-15 fix: update to node and gateway variables for the 18th May tests
    [config.h]
2026-05-18 feat: add particle sensor wake/sleep
2026-05-18 fix: minor bug fix
    [utils.h]
2026-05-18 Fix: prints
2026-05-18 feat(sensor_logic): add more correct rounding to pm_average
    [sensor_logic.cpp]
2026-05-18 fix(gateway): SF10 -> SF12
    [config.h]
2026-05-20 feat(error_handler): add more rigorous error handling
    [utils.cpp]
2026-05-20 fix: remove accidental buffering_counter incrementation bug
    buffering_counter already gets incremented in src.ino
    [encode_payload.cpp]
2026-05-20 chore: add particle sensor debug prints
2026-05-20 fix(sensor_logic): remove averaging from particle sensor
    Needs cleanup.
    [sensor_logic.cpp]
2026-05-28 fix: add particle sensor parsing bug fix
    Added correct handling of values above 255 PM1/2.5
    [sensor_logic.cpp]
2026-05-28 feat: calibration of sound sensor
2026-05-29 fix: add safer error handling
    Also updated transmit_payload to abort if the LoRa chip fails to initialise.
    [encode_payload.cpp, utils.cpp]
2026-05-29 feat: improved db approimation by fitting a function to values from manual measurements
    [results.csv]
2026-05-29 fix: add nvs bug fix
    Also updated boot_count to a 16 uns bit to combat nvs overwrites
    [config.h, utils.cpp, utils.h]
2026-05-29 fix: roll back unintended changes from d2927da4a05ac34ca89b6b7fceed9bf6edf05bd0
    [sensor_logic.cpp]
2026-05-29 fix: add minor nvs bug fix
    [utils.cpp]
2026-05-29 feat: changed sample window to 15 minutes
2026-05-29 feat: add particle sensor read retries
2026-05-29 Reverted to old settings
    [config.h]
2026-08-21 Compare official data with mints test run
    [official_data.csv, our_raw_data.csv]
